mwelling/rp2040-pmod/README.md

# rp2040-pmod

Simple RP2040 MCU based PMOD

# Features
* RP2040 MCU
* SPI flash
* USB
* 2x6 PMOD
* Analog header
* LED
* 1 User Button
* Reset and Boot Button
* Debug header

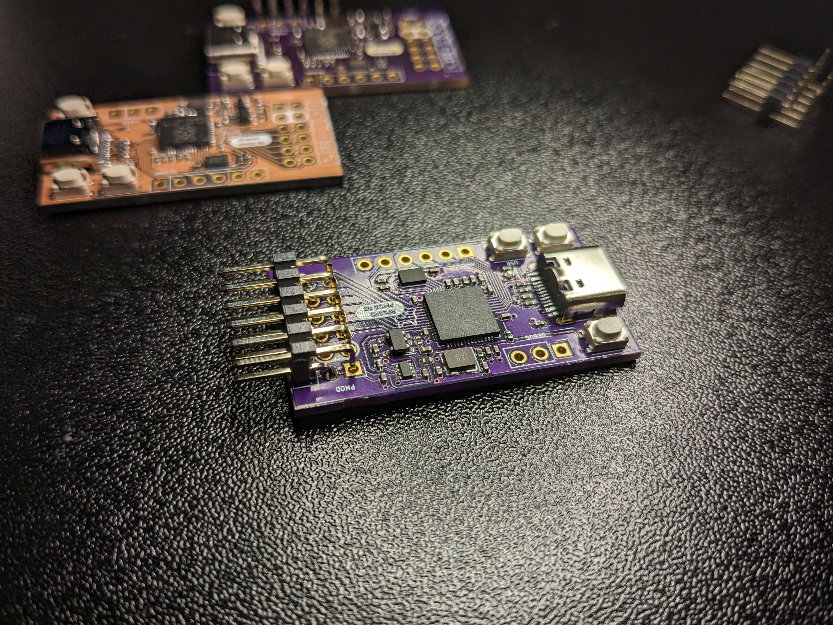
[picture p1: images/RP2040-PMOD.jpg]
