mwelling/rp2040-pmod/rp2040-pmod.kicad_pcb

## KiCad design rp2040-pmod.kicad_pcb (2024-11-29)

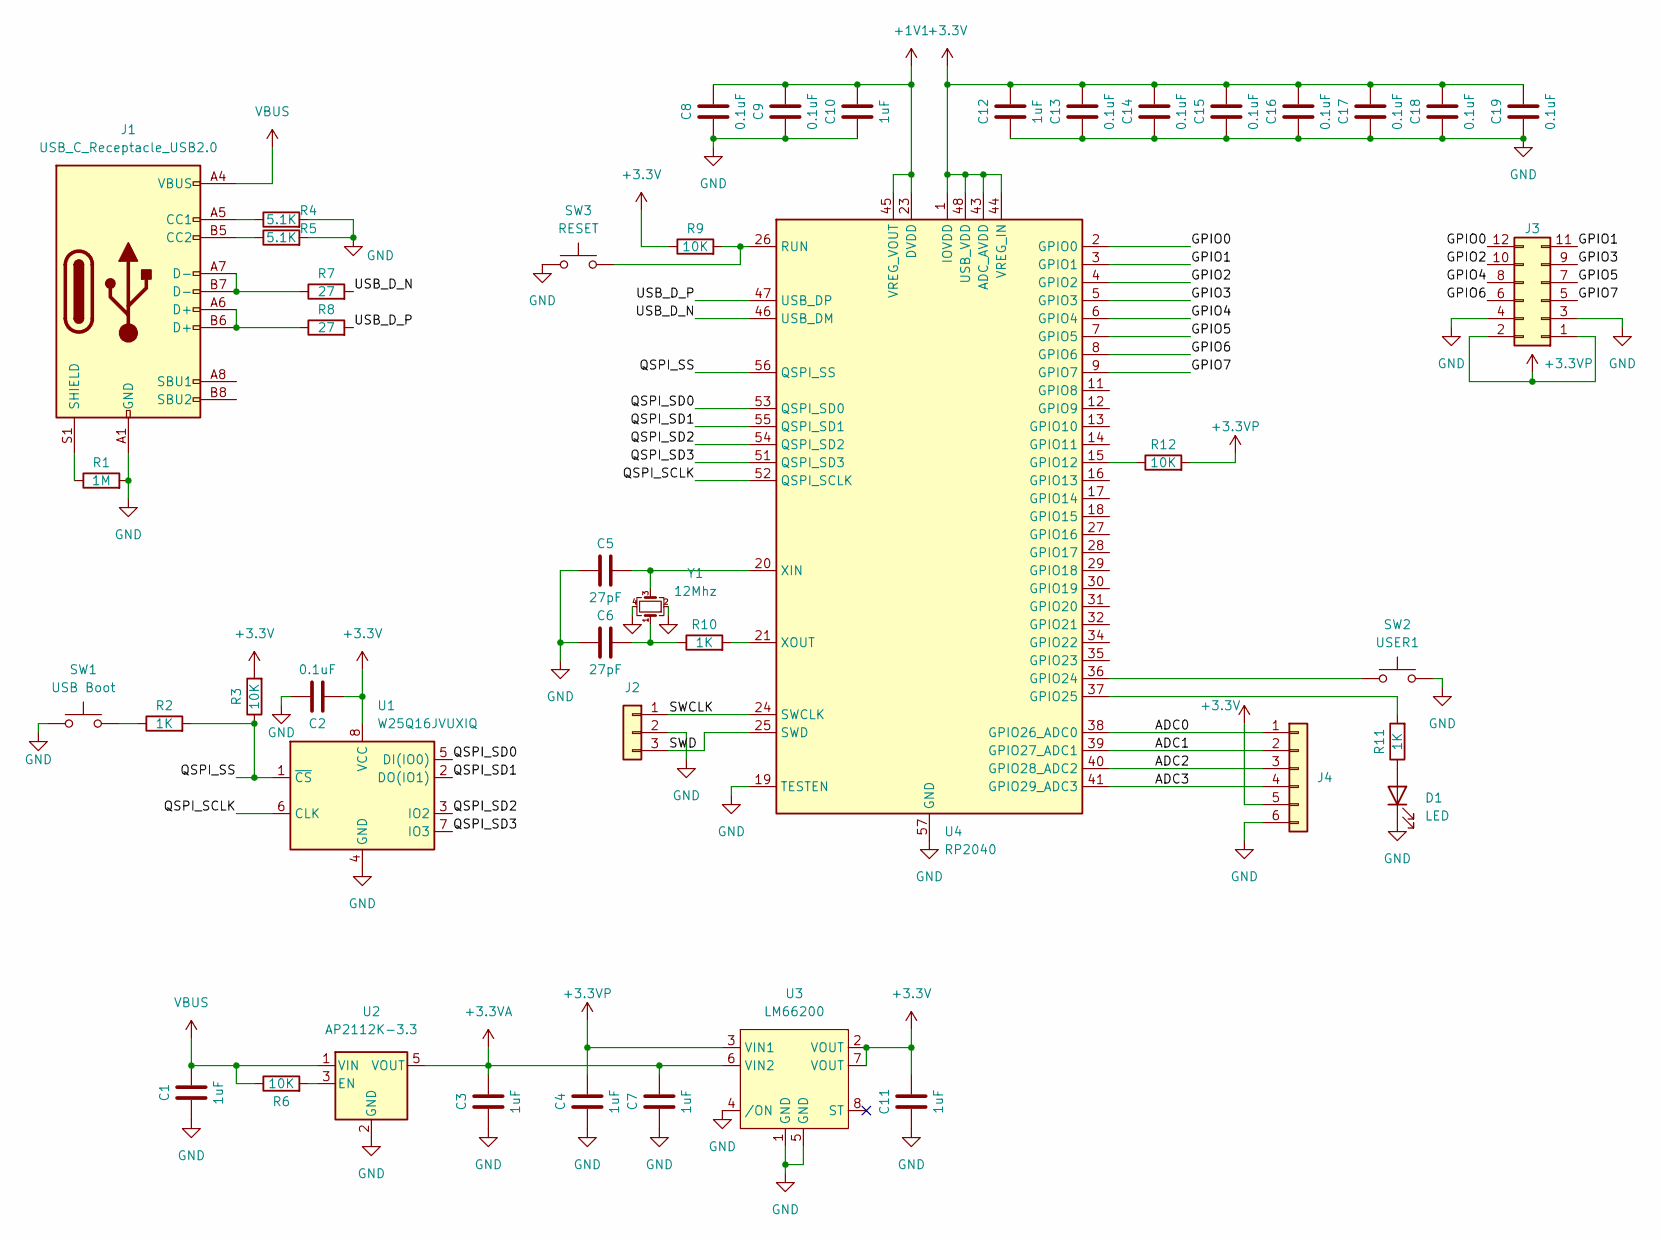
[picture p3: schematic rp2040-pmod.kicad_sch]

Parts:
C1, C3, C4, C7, C10, C11, C12: 1uF; C_0402_1005Metric
C2, C8, C9, C13, C14, C15, C16, C17, C18, C19: 0.1uF; C_0402_1005Metric
C5, C6: 27pF; C_0402_1005Metric
D1: LED; LED_0402_1005Metric
J1: USB_C_Receptacle_USB2.0; USB_C_Receptacle_HRO_TYPE-C-31-M-12
J2: Conn_01x03; PinHeader_1x03_P2.54mm_Vertical
J3: Conn_02x06_Odd_Even; PinHeader_2x06_P2.54mm_Horizontal
J4: Conn_01x06; PinHeader_1x06_P2.54mm_Vertical
R1: 1M; R_0402_1005Metric
R2, R10, R11: 1K; R_0402_1005Metric
R3, R6, R9, R12: 10K; R_0402_1005Metric
R4, R5: 5.1K; R_0402_1005Metric
R7, R8: 27; R_0402_1005Metric
SW1: USB Boot; SW_Push_1P1T_NO_Vertical_Wuerth_434133025816
SW2: USER1; SW_Push_1P1T_NO_Vertical_Wuerth_434133025816
SW3: RESET; SW_Push_1P1T_NO_Vertical_Wuerth_434133025816
U1: W25Q16JVUXIQ; USON-8_2x3
U2: AP2112K-3.3; SOT-23-5
U3: LM66200; SOT-5x3
U4: RP2040; QFN-56-1EP_7x7mm_P0.4mm_EP3.2x3.2mm
Y1: 12Mhz; Crystal_SMD_Abracon_ABM8G-4Pin_3.2x2.5mm

Connections:
+1V1: C8.2, C9.2, C10.2, U4.23 (DVDD), U4.45 (VREG_VOUT), U4.50 (DVDD)
+3.3V: C2.1, C11.2, C12.2, C13.2, C14.2, C15.2, C16.2, C17.2, C18.2, C19.2, J4.5, R3.2, R9.1, U1.8 (VCC), U3.2 (VOUT), U3.7 (VOUT), U4.1 (IOVDD), U4.10 (IOVDD), U4.22 (IOVDD), U4.33 (IOVDD), U4.42 (IOVDD), U4.43 (ADC_AVDD), U4.44 (VREG_IN), U4.48 (USB_VDD), U4.49 (IOVDD)
+3.3VA: C3.2, C7.2, U2.5 (VOUT), U3.6 (VIN2)
+3.3VP: C4.2, J3.1, J3.2, R12.2, U3.3 (VIN1)
/ADC0: J4.1, U4.38 (GPIO26_ADC0)
/ADC1: J4.2, U4.39 (GPIO27_ADC1)
/ADC2: J4.3, U4.40 (GPIO28_ADC2)
/ADC3: J4.4, U4.41 (GPIO29_ADC3)
/GPIO0: J3.12, U4.2 (GPIO0)
/GPIO1: J3.11, U4.3 (GPIO1)
/GPIO2: J3.10, U4.4 (GPIO2)
/GPIO3: J3.9, U4.5 (GPIO3)
/GPIO4: J3.8, U4.6 (GPIO4)
/GPIO5: J3.7, U4.7 (GPIO5)
/GPIO6: J3.6, U4.8 (GPIO6)
/GPIO7: J3.5, U4.9 (GPIO7)
/QSPI_SCLK: U1.6 (CLK), U4.52 (QSPI_SCLK)
/QSPI_SD0: U1.5 (DI(IO0)), U4.53 (QSPI_SD0)
/QSPI_SD1: U1.2 (DO(IO1)), U4.55 (QSPI_SD1)
/QSPI_SD2: U1.3 (IO2), U4.54 (QSPI_SD2)
/QSPI_SD3: U1.7 (IO3), U4.51 (QSPI_SD3)
/QSPI_SS: R2.2, R3.1, U1.1 (~CS), U4.56 (QSPI_SS)
/SWCLK: J2.1, U4.24 (SWCLK)
/SWD: J2.3, U4.25 (SWD)
/USB_D_N: R7.2, U4.46 (USB_DM)
/USB_D_P: R8.2, U4.47 (USB_DP)
GND: C1.1, C2.2, C3.1, C4.1, C5.1, C6.1, C7.1, C8.1, C9.1, C10.1, C11.1, C12.1, C13.1, C14.1, C15.1, C16.1, C17.1, C18.1, C19.1, D1.1 (K), J1.A1 (GND), J1.A12 (GND), J1.B1 (GND), J1.B12 (GND), J2.2, J3.3, J3.4, J4.6, R1.2, R4.2, R5.2, SW1.1, SW2.2, SW3.1, U1.4 (GND), U2.2 (GND), U3.1 (GND), U3.4 (/ON), U3.5 (GND), U4.19 (TESTEN), U4.57 (GND), Y1.2, Y1.4
unnamed: C5.2, U4.20 (XIN), Y1.3
unnamed: C6.2, R10.1, Y1.1
unnamed: D1.2 (A), R11.1
unnamed: J1.A5 (CC1), R4.1
unnamed: J1.A6 (D+), J1.B6 (D+), R8.1
unnamed: J1.A7 (D-), J1.B7 (D-), R7.1
unnamed: J1.B5 (CC2), R5.1
unnamed: J1.S1 (SHIELD), R1.1
unnamed: R2.1, SW1.2
unnamed: R6.2, U2.3 (EN)
unnamed: R9.2, SW3.2, U4.26 (RUN)
unnamed: R10.2, U4.21 (XOUT)
unnamed: R11.2, U4.37 (GPIO25)
unnamed: SW2.1, U4.36 (GPIO24)
unnamed: R12.1, U4.15 (GPIO12)
VBUS: C1.2, J1.A4 (VBUS), J1.A9 (VBUS), J1.B4 (VBUS), J1.B9 (VBUS), R6.1, U2.1 (VIN)

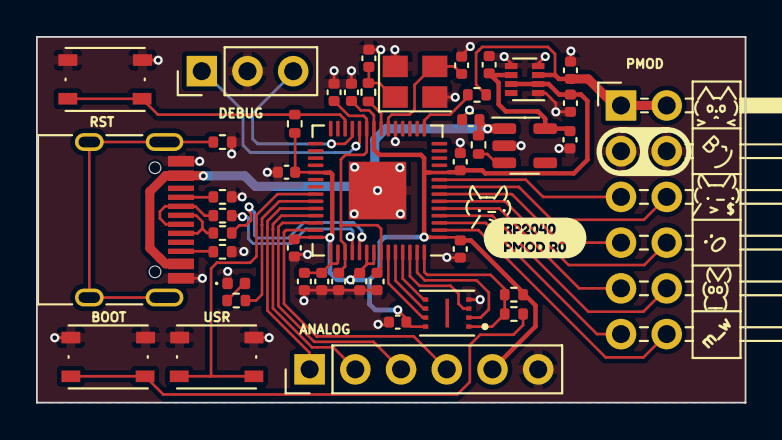
[picture p4: board rp2040-pmod.kicad_pcb from above]

Board: 2 copper layers, 39.4 x 20.3 mm, 46 parts (1 on the bottom side), 43 nets.

Other parts of the board:
kibuzzard-6385637E, kibuzzard-6385637E#2: G***; kibuzzard-6385637E
