mwelling/rp2040-pmod/(commit log)

2022-11-01 Initial commit for peer review
    [rp2040-pmod.kicad_pcb, rp2040-pmod.kicad_sch]
2022-11-01 Routed in 2 layers
    [rp2040-pmod.kicad_pcb]
2022-11-02 Switch to .1" debug header
    Also add some silkscreen labels on the bottom.
    [rp2040-pmod.kicad_pcb, rp2040-pmod.kicad_sch]
2022-11-02 Fix some new DRCs
    [rp2040-pmod.kicad_pcb]
2022-11-15 Update LM66200 footprint
    The footprint used was the wrong pitch and width. :(
    New footprint is close enough to the datasheet to actually work. :)
    [rp2040-pmod.kicad_pcb, rp2040-pmod.kicad_sch]
2022-11-15 Switch flash, add ADC header, add PMOD power detection
    USON pattern swiped from emeb's library.
    https://github.com/emeb/KiCad_Libs
    [rp2040-pmod.kicad_pcb, rp2040-pmod.kicad_sch]
2022-11-30 Silkscreen updates
    [rp2040-pmod.kicad_pcb]
2023-03-06 Add BOM and schematic PDF
2023-03-06 Add image of the board
2024-11-29 Update to Kicad 8
    [rp2040-pmod.kicad_pcb, rp2040-pmod.kicad_sch]
